sini6a/dk-simple-remote/FreeCAD/3D Enclosure Simple.FCStd

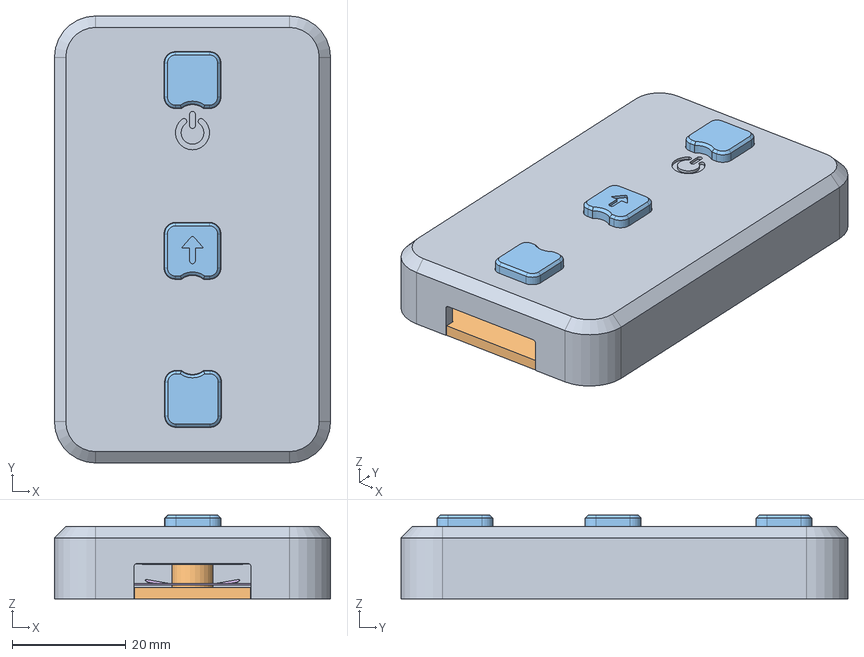
[picture p2: CAD file, 2026-11-10]
FreeCAD/3D Enclosure Simple.FCStd
48.5 x 78.5 x 14.7 mm
Top Body
Bottom Cover
Buttons
Pads050
Pads051
Pads052
Pads053
Pads054
Pads055
Pads056
Pads057
Pads058
Pads059
Pads060
Pads061
Pads062
Pads063
Pads064
Pads065
Pads066
Pads067
Pads068
Pads069
Pads070
Pads071
Pads072
Pads073
Pads074
Pads075
Pads076
Pads077
Pads078
Pads079
Pads080
Pads081
Pads082
Pads083
Pads084
Pads085
Pads086
Pads087
Pads088
Pads089
Pads090
Pads091
Pads092
Pads093
Pads094
Pads095
Pads096
Pads097
Pads098
SW_Push_1P1T_NO_CK_KSC7xxJ006
C_0603_1608Metric002
R_0402_1005Metric002
C_0402_1005Metric005
C_0402_1005Metric006
SW_Push_1P1T_NO_CK_KSC7xxJ007
L_APV_ANR3011
R_0402_1005Metric003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
