sini6a/dk-simple-remote/KiCad/Models/BC-2003.STEP

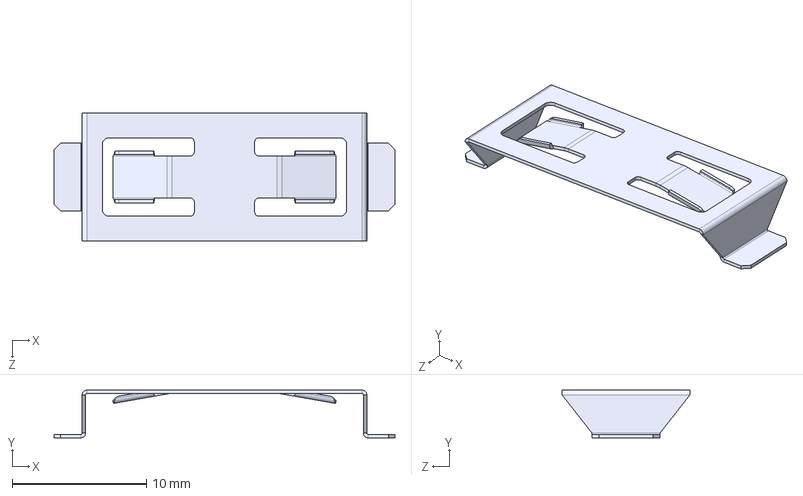
[picture p3: CAD file, 2026-11-10]
KiCad/Models/BC-2003.STEP
25.4 x 3.56 x 9.53 mm
