sini6a/dk-simple-remote/FreeCAD/PCB Model.step

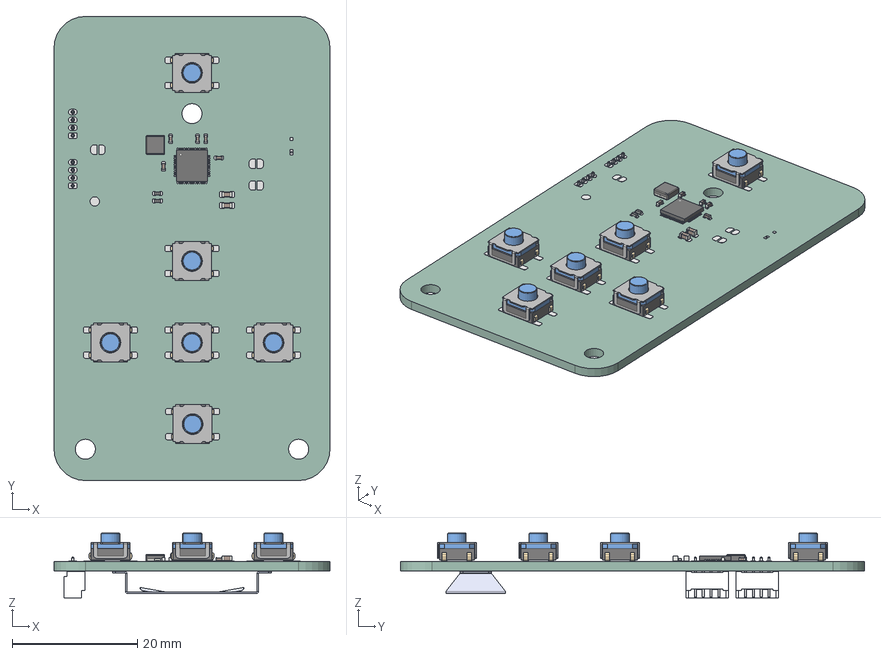
[picture p4: CAD file, 2026-11-10]
FreeCAD/PCB Model.step
44.0 x 74.0 x 10.3 mm
Pads
SW_Push_1P1T_NO_CK_KSC7xxJ x 6
C_0603_1608Metric x 2
R_0402_1005Metric x 2
C_0402_1005Metric x 5
L_APV_ANR3010
BC-2003
JST - GH - Thru (V) - 4Pin - 1.25mm x 2
simple-remote-nrf_pad
simple-remote-nrf_PCB
