sini6a/dk-simple-remote/KiCad/Models/QFN48-5x5mm v3.step

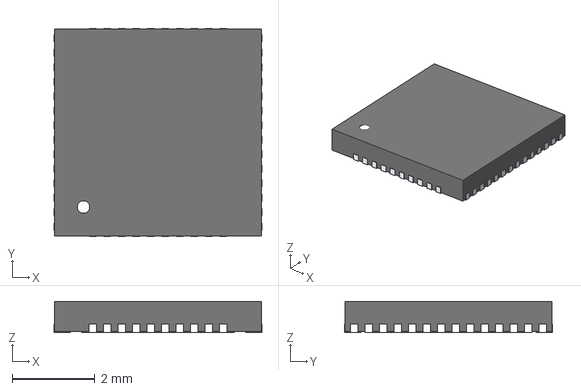
[picture p5: CAD file, 2026-11-10]
KiCad/Models/QFN48-5x5mm v3.step
5.03 x 5.03 x 0.75 mm
Pads
