sini6a/dk-simple-remote/FreeCAD/3D Enclosure.FCStd

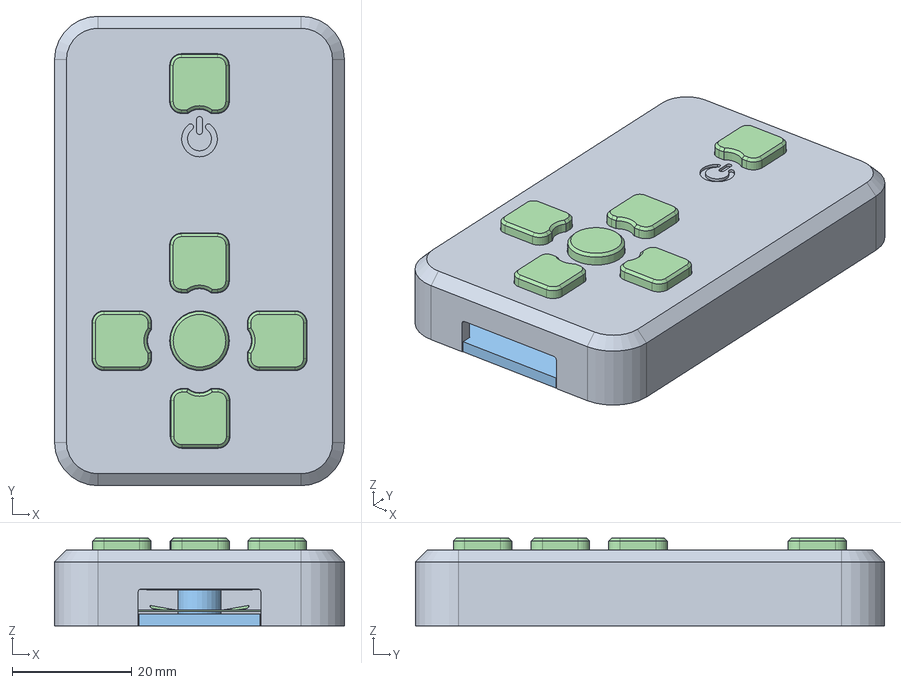
[picture p6: CAD file, 2026-11-10]
FreeCAD/3D Enclosure.FCStd
48.5 x 78.5 x 14.7 mm
Top Body
Pads
Pads001
Pads002
Pads003
Pads004
Pads005
Pads006
Pads007
Pads008
Pads009
Pads010
Pads011
Pads012
Pads013
Pads014
Pads015
Pads016
Pads017
Pads018
Pads019
Pads020
Pads021
Pads022
Pads023
Pads024
Pads025
Pads026
Pads027
Pads028
Pads029
Pads030
Pads031
Pads032
Pads033
Pads034
Pads035
Pads036
Pads037
Pads038
Pads039
Pads040
Pads041
Pads042
Pads043
Pads044
Pads045
Pads046
Pads047
Pads048
SW_Push_1P1T_NO_CK_KSC7xxJ
C_0603_1608Metric
R_0402_1005Metric
C_0402_1005Metric
C_0402_1005Metric001
SW_Push_1P1T_NO_CK_KSC7xxJ001
L_APV_ANR3010
R_0402_1005Metric001
SW_Push_1P1T_NO_CK_KSC7xxJ002
C_0402_1005Metric002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
