sini6a/dk-simple-remote/KiCad/Models/QFN48-5x5mm.step

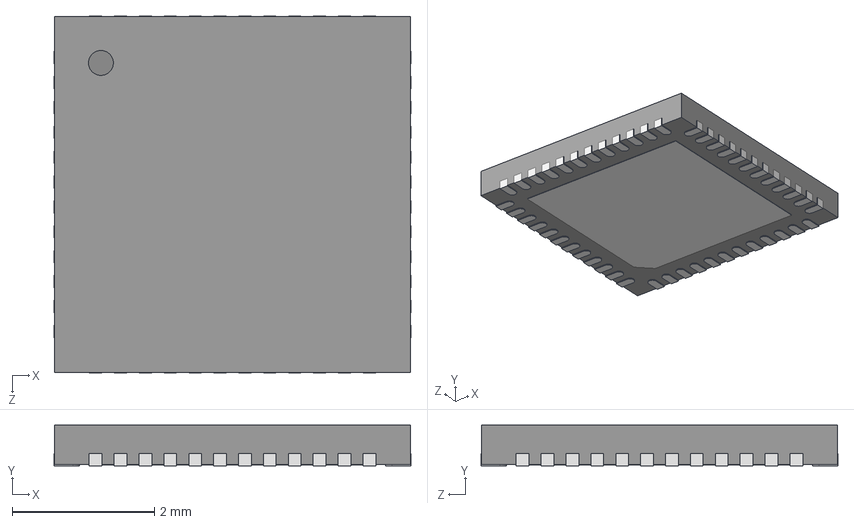
[picture p7: CAD file, 2026-11-10]
KiCad/Models/QFN48-5x5mm.step
5.02 x 0.57 x 5.02 mm
