sini6a/dk-simple-remote/KiCad/Models/JST - GH - Thru (V) - 4Pin - 1.25mm.stp

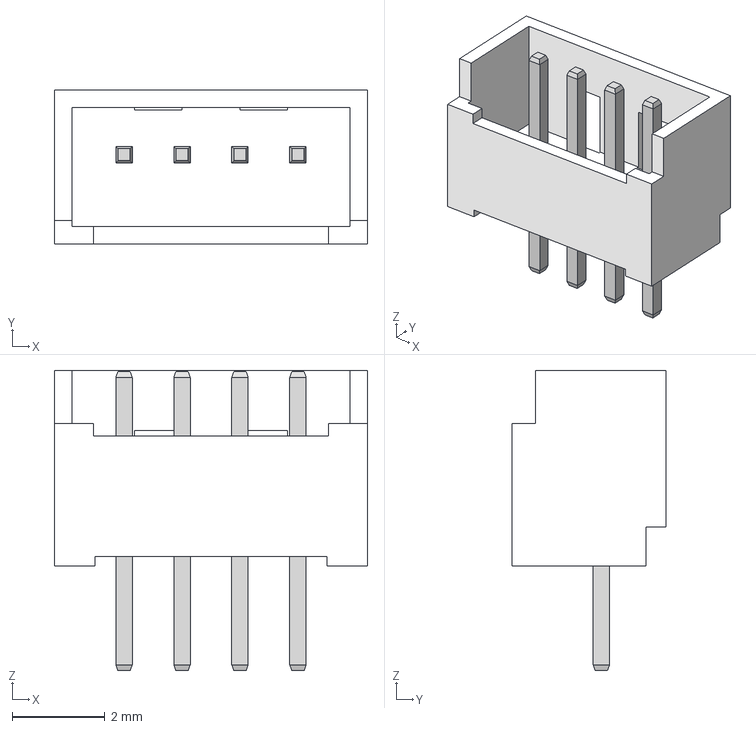
[picture p8: CAD file, 2026-11-10]
KiCad/Models/JST - GH - Thru (V) - 4Pin - 1.25mm.stp
6.75 x 3.33 x 6.48 mm
