sini6a/dk-simple-remote/KiCad/dk-simple-remote.kicad_pcb

## KiCad design KiCad/dk-simple-remote.kicad_pcb (2026-11-10)

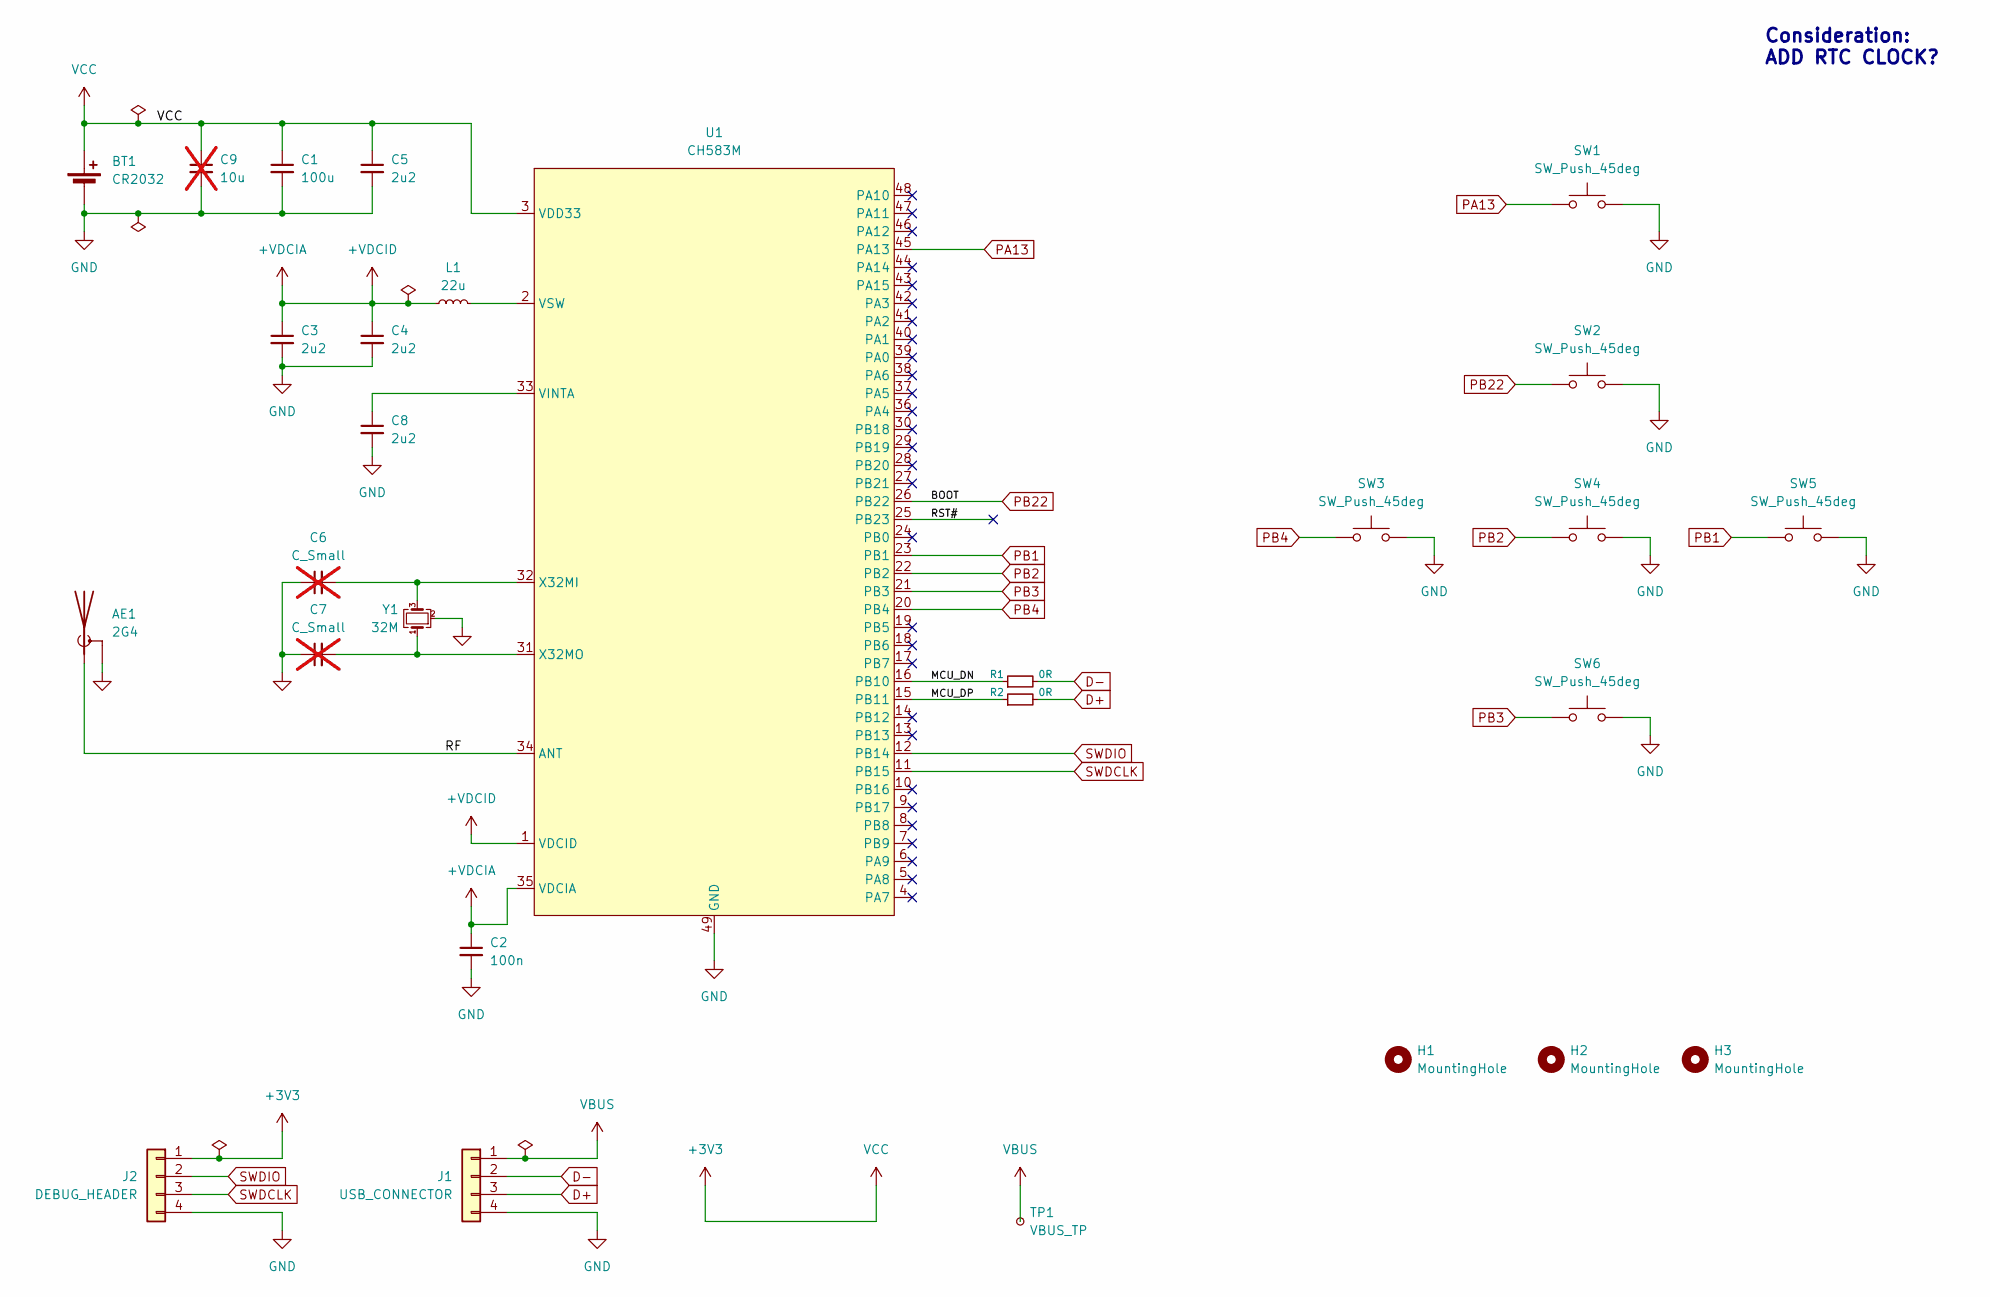
[picture p9: schematic dk-simple-remote.kicad_sch]

Parts:
AE1: 2G4; Texas_SWRA117D_2.4GHz_Left
BT1: CR2032; BatteryHolder_MPD_BC2003_1x2032
C1: 100u; C_1206_3216Metric; MPN C15008
C2: 100n; C_0402_1005Metric; MPN C1525
C3, C4, C5, C8: 2u2; C_0402_1005Metric; MPN C12530
C6, C7: C_Small; C_0402_1005Metric; not fitted
C9: 10u; C_0603_1608Metric; MPN C1713; not fitted
H1, H2, H3: MountingHole; MountingHole_3.2mm_M3_ISO14580
J1: USB_CONNECTOR; Hirose_DF13-04P-1.25DSA_1x04_P1.25mm_Vertical
J2: DEBUG_HEADER; Hirose_DF13-04P-1.25DSA_1x04_P1.25mm_Vertical
L1: 22u; L_APV_ANR3010; MPN C6364775
R1, R2: 0R; R_0402_1005Metric; MPN C17168
SW1, SW2, SW3, SW4, SW5, SW6: SW_Push_45deg; SW_Push_1P1T_NO_E-Switch_TL3301NxxxxxG; MPN C2837531
TP1: VBUS_TP; TestPoint_Pad_D1.5mm
U1: CH583M; QFN-48-1EP_5x5mm_P0.35mm_EP3.7x3.7mm
Y1: 32M; Crystal_SMD_2016-4Pin_2.0x1.6mm; MPN C383840

Connections:
+3V3: BT1.1 (+), C1.1, C5.1, C9.1, J2.1, U1.3 (VDD33)
+VDCIA: C2.1, C3.1, C4.1, L1.1, U1.1 (VDCID), U1.35 (VDCIA)
/MCU_DN: R1.1, U1.16 (PB10)
/MCU_DP: R2.1, U1.15 (PB11)
/RF: AE1.1 (A), U1.34 (ANT)
/RST#: U1.25 (PB23)
D+: J1.3, R2.2
D-: J1.2, R1.2
GND: AE1.2 (Shield), BT1.2 (-), C1.2, C2.2, C3.2, C4.2, C5.2, C6.1, C7.1, C8.2, C9.2, J1.4, J2.4, SW1.2, SW2.2, SW3.2, SW4.2, SW5.2, SW6.2, U1.49 (GND), Y1.2 (G), Y1.4 (G)
unnamed: C8.1, U1.33 (VINTA)
unnamed: L1.2, U1.2 (VSW)
unnamed: C6.2, U1.32 (X32MI), Y1.3
unnamed: C7.2, U1.31 (X32MO), Y1.1
PA13: SW1.1, U1.45 (PA13)
PB1: SW5.1, U1.23 (PB1)
PB2: SW4.1, U1.22 (PB2)
PB3: SW6.1, U1.21 (PB3)
PB4: SW3.1, U1.20 (PB4)
PB22: SW2.1, U1.26 (PB22)
SWDCLK: J2.3, U1.11 (PB15)
SWDIO: J2.2, U1.12 (PB14)
VBUS: J1.1, TP1.1 (1_1)

Notes on the sheet:
Consideration: ADD RTC CLOCK?

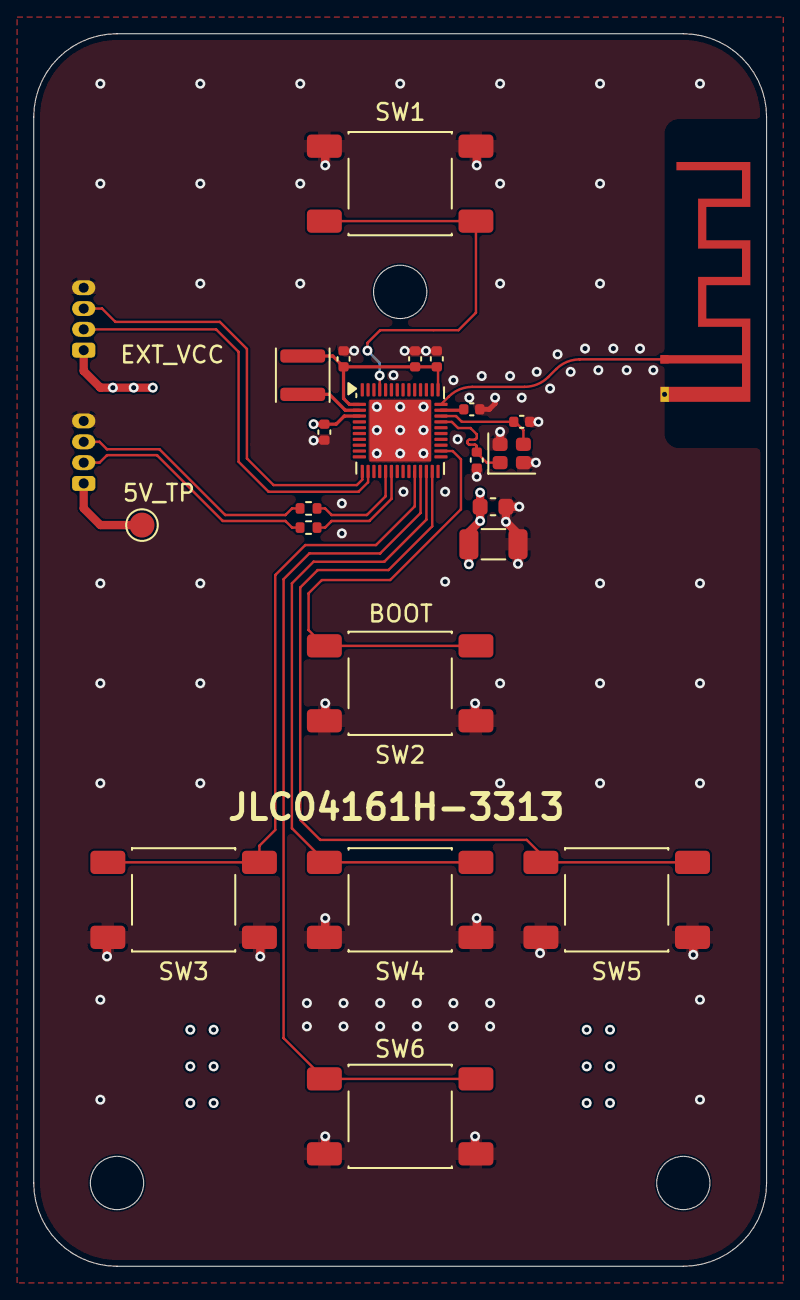
[picture p10: board dk-simple-remote.kicad_pcb from above]

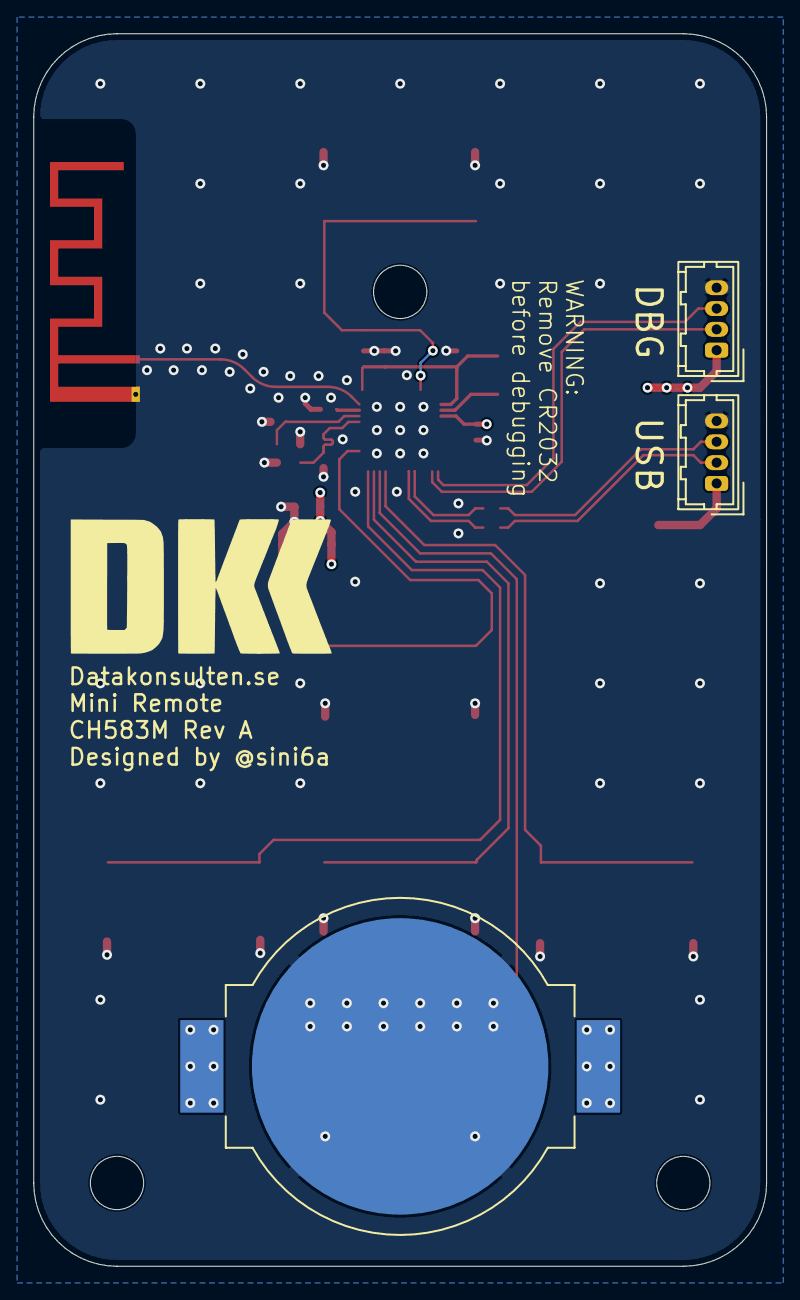
[picture p11: board dk-simple-remote.kicad_pcb from below]

Board: 4 copper layers, 44.0 x 74.0 mm, 28 parts (3 on the bottom side), 21 nets.
